VALKPC/VF-1/README.md

# VF-1
STEP assets, BOM and build details for making your own VF-1 case.

github

Right from the start, we wanted to build an ecology of case design that evolves over time. [Start from our barebones kit](https://valkpc.com/products/vf-1-barebones-kit) or build completely from scratch, we can't wait to see what people will build! :)

Run your own garage CNC or have some serious manufacturing setups? Love to offer your modded parts for VALKPC? [We would love to hear from you!](https://valkpc.com/pages/get-in-touch)

Please refer to details in [Panels](Panels).

We are pleased to announce that we are [OSHWA certified open source hardware](https://certification.oshwa.org/sg000005.html).
oshw-SG000005

Hardware and documentation licensed under **[CC BY-SA 4.0 International license](https://creativecommons.org/licenses/by-sa/4.0/)**.
