VALKPC/VF-1/Panels/BOM.md

Bill of materials (BOM)
|Model|Revision|
|-|-|
|VF-1|V2.0|

|#|Part Name|Part Description|Source|Quantity|
|-|-|-|-|-|
|1|Frame-BK|Back frame - 3mm Aluminium|Fabricate|1|
|2|Frame-FR|Front frame - 3mm Aluminium|Fabricate|1|
|3|Frame-PSU|PSU mounting frame - 3mm Aluminium|Fabricate|1|
|4|Shell-BK|Back shell - 3mm sheet material|Fabricate|1|
|5|Shell-FR|Front shell - 3mm sheet material|Fabricate|1|
|6|Shell-BT|Bottom shell - 3mm sheet material|Fabricate|1|
|7|Shell-TP|Top shell - 3mm sheet material|Fabricate|1|
|8|Shell-FC|Front corner shell|Fabricate / 3D-print|2|
|9|Shell-BC|Back corner shell|Fabricate / 3D-print|2|
|10|Window|Window - 2mm acrylic|Fabricate|2|
|11|ISO 7380 M3x6 A2|Button-head M3x6mm|Standard component|54|
|12|ISO 7380 M3x10 A2|Button-head M3x10mm|Standard component|6|
|13|ISO 7380 M3x20 A2|Button-head M3x20mm|Standard component|8|
|14|UNC #6/32x1/4 A2|Button-head #6/32x1/4"|Standard component|4|
|15|DIN 7991 M3x6 A2|Flat-head M3x6mm|Standard component|10|
|16|DIN 7991 M3x8 A2|Flat-head M3x8mm|Standard component|7|
|17|DIN 7991 M3x10 A2|Flat-head M3x10mm|Standard component|2|
|18|DIN 7991 M3x25 A2|Flat-head M3x25mm|Standard component|2|
|19|934 M3 A2|M3 nut|Standard component|8|
|20|Dowel 3mm|Cylindrical pin - 3mm|Standard component|6|
|21|Feet|Elastic feet|Fabricate / 3D-print|6|
|22|GPU support|GPU support|Fabricate / 3D-print|1|
|23|IEC extension|IEC extension|Fabricate / 3D-print|1|
|24|Support bracket|Support bracket|Fabricate / 3D-print|1|
|25|Switch|12mm LED Vandal resistant switch and wiring|Standard component|1|
|26|USB port|USB-C Type-C 3.1 Gen 2|Standard component|1|
|27|Power cord|IEC power extension cord (left and right angle)|Standard component|2|
|28|Square block|Square mounting block|Standard component|10|
|29|Triangle block|Triangle mounting block|Standard component|2|
|30|Filter|Filter frame and filter|Fabricate / 3D-print|2|
|31|Cross-brace|10 x 10mm aluminium extrusion|Standard component|1|
|32|IO Panel|ITX IO Panel|Fabricate|1|
