VALKPC/VF-1/(commit log)

2021-06-11 Initial commit for design files
    [Frame-BK.dxf, Frame-FR.dxf, Frame-PU.dxf, Shell-BK.dxf, Shell-BT.dxf, Shell-FR.dxf, Shell-TP.dxf]
2021-10-04 Adding BOM
2022-05-20 Add files via upload
    V2.1 - correction to some screw length
